UCONNFSAE/DashboardPCB/FSAE Main Panel/FSAE Main Panel.pdf

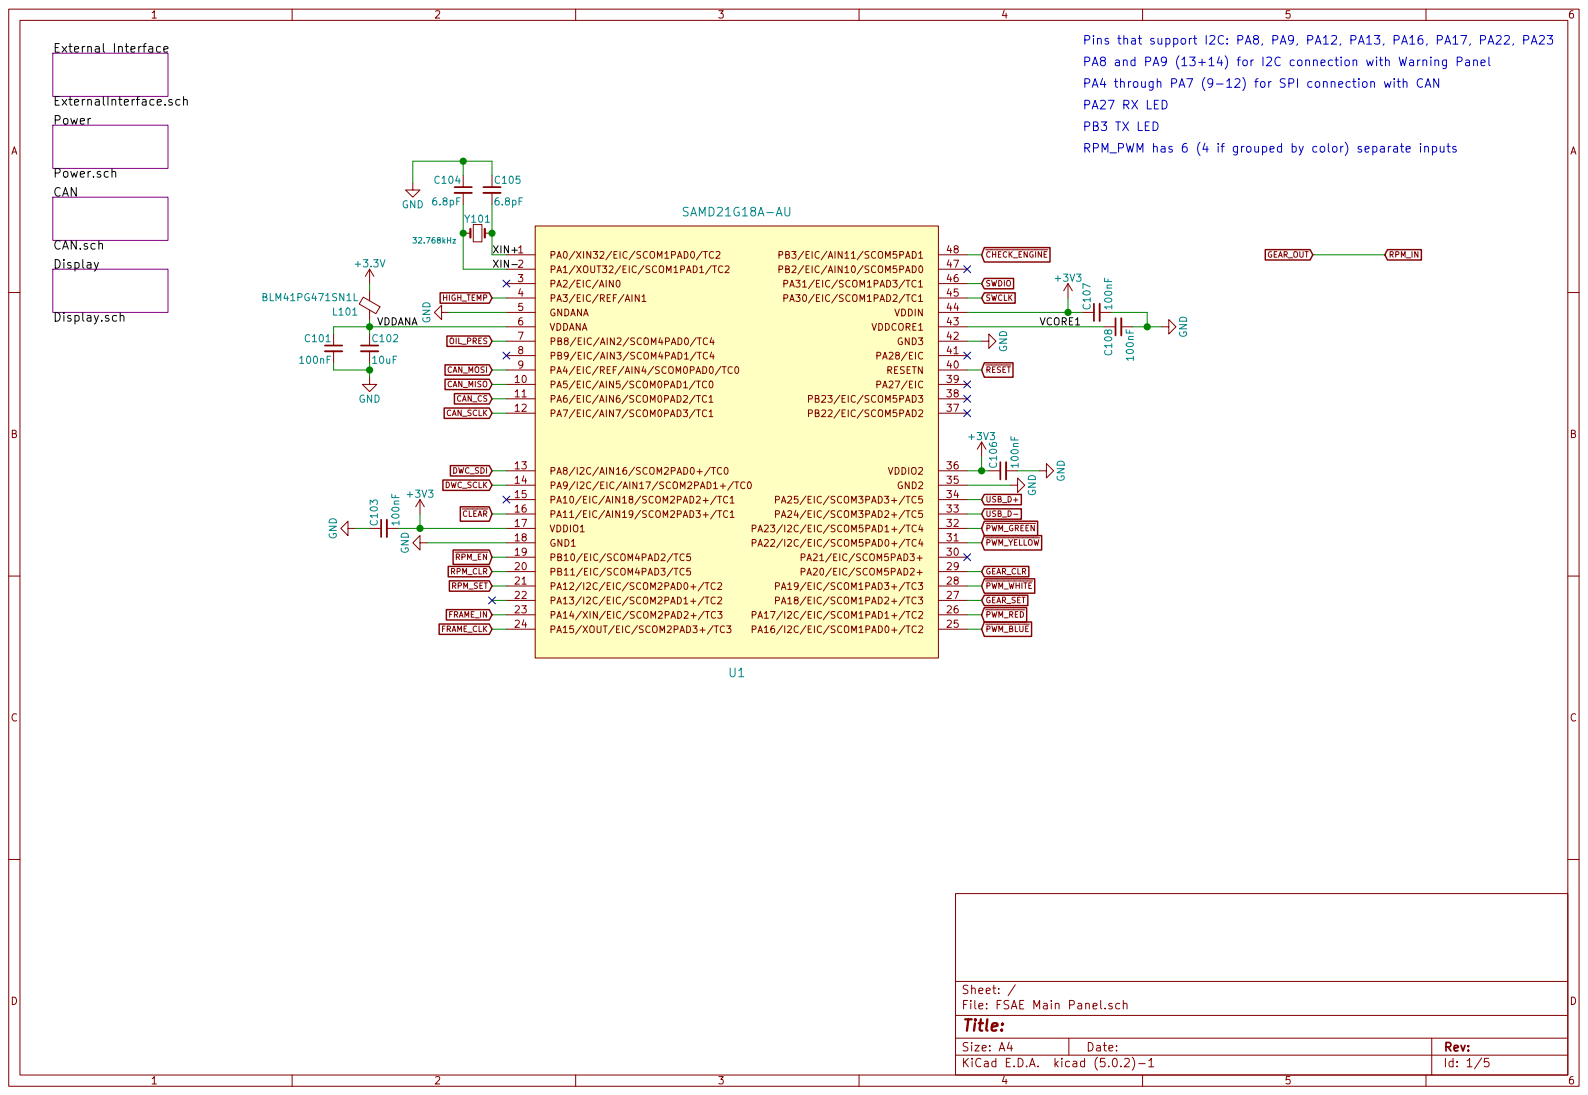
[picture p1: page 1]

External Interface ExternalInterface.sch Power Power.sch CAN

PA4 through PA7 (9-12) for SPI connection with CAN

PB3 TX LED
RPM_PWM has 6 (4 if grouped by color) separate inputs

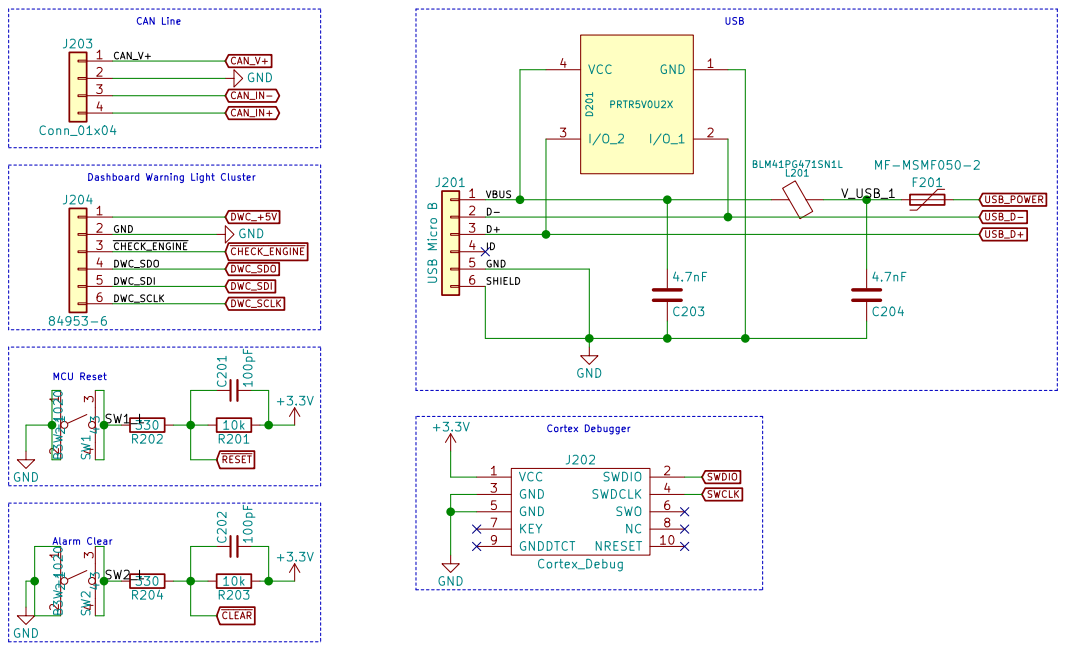
[picture p2: page 2]

DWC_SDI DWC_SCLK Dashboard Warning Light Cluster 1

4SW1 B3W-1020 MCU Reset Alarm Clear GND GND

Id: 2/5 Title: File: ExternalInterface.sch Sheet: /External Interface/

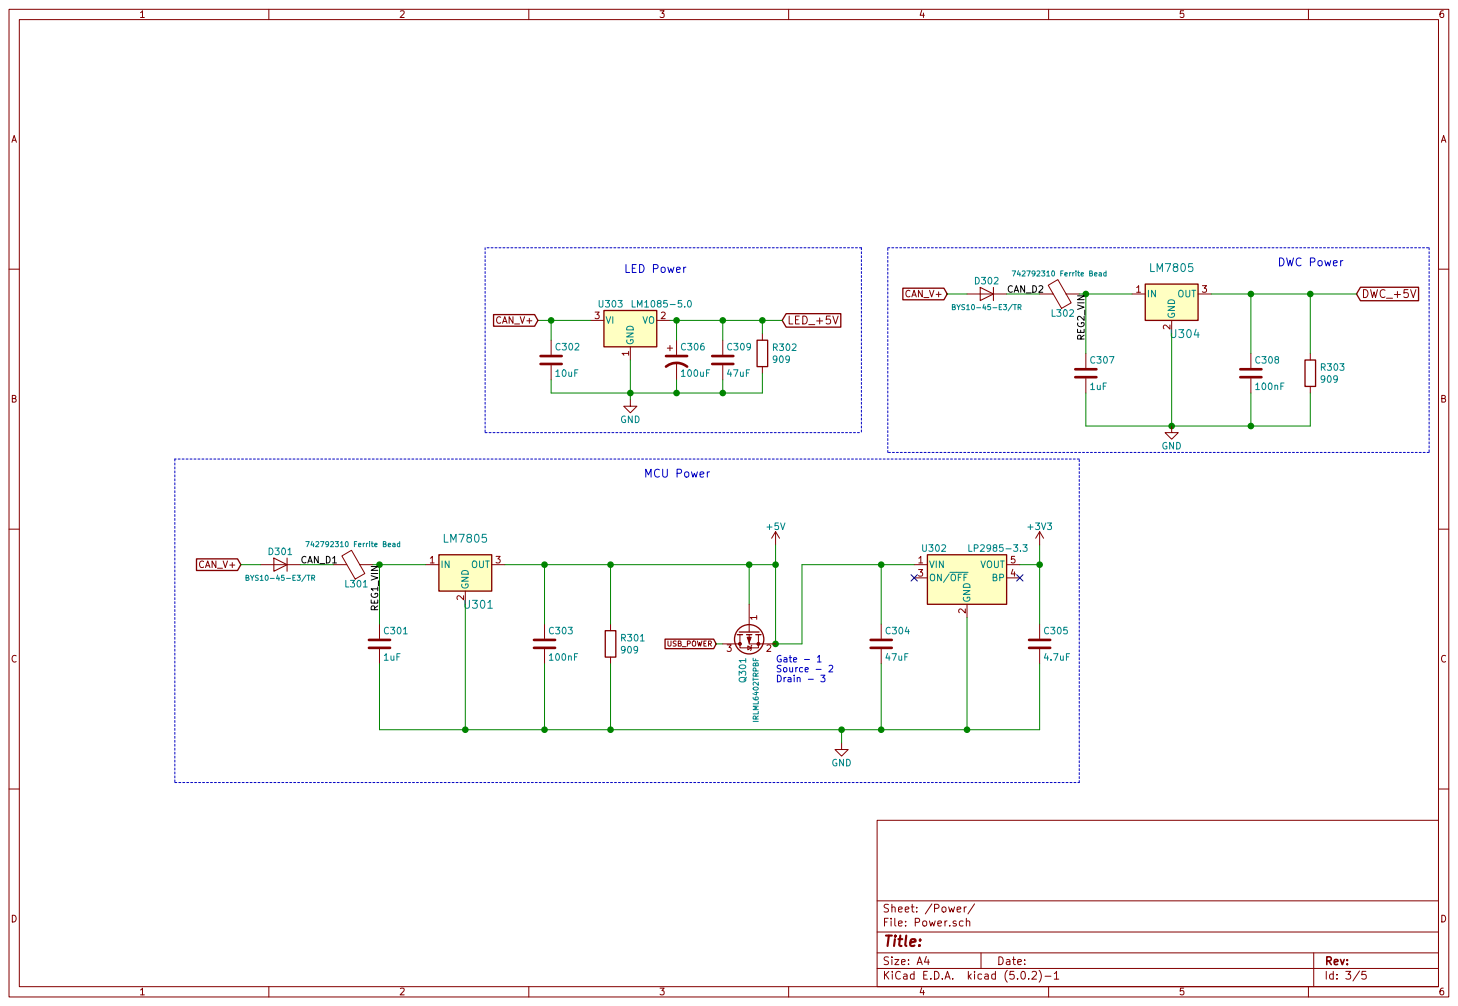
[picture p3: page 3]

Id: 3/5 Title: File: Power.sch Sheet: /Power/ D301

2 ON/OFF 3 BP 4 VOUT 5 U302 LP2985-3.3 C304

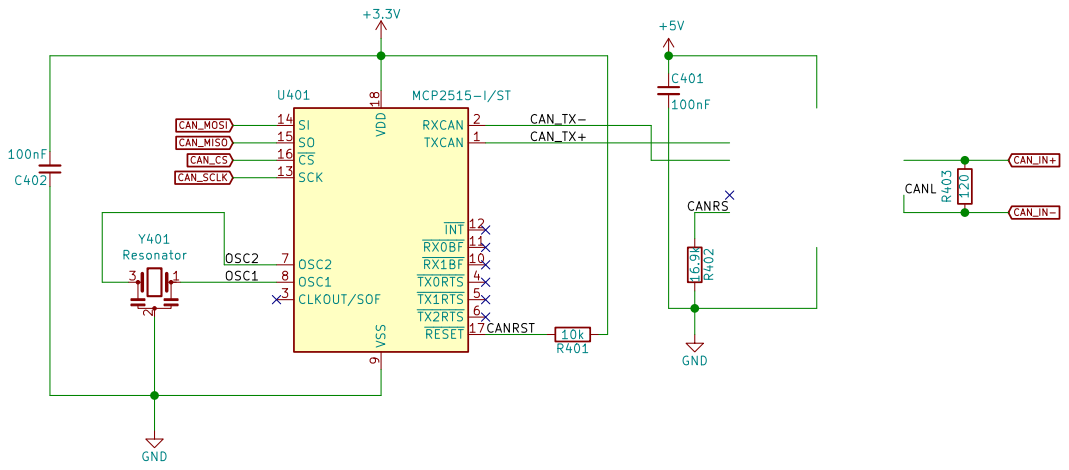
[picture p4: page 4]

Id: 4/5 Title: File: CAN.sch Sheet: /CAN/

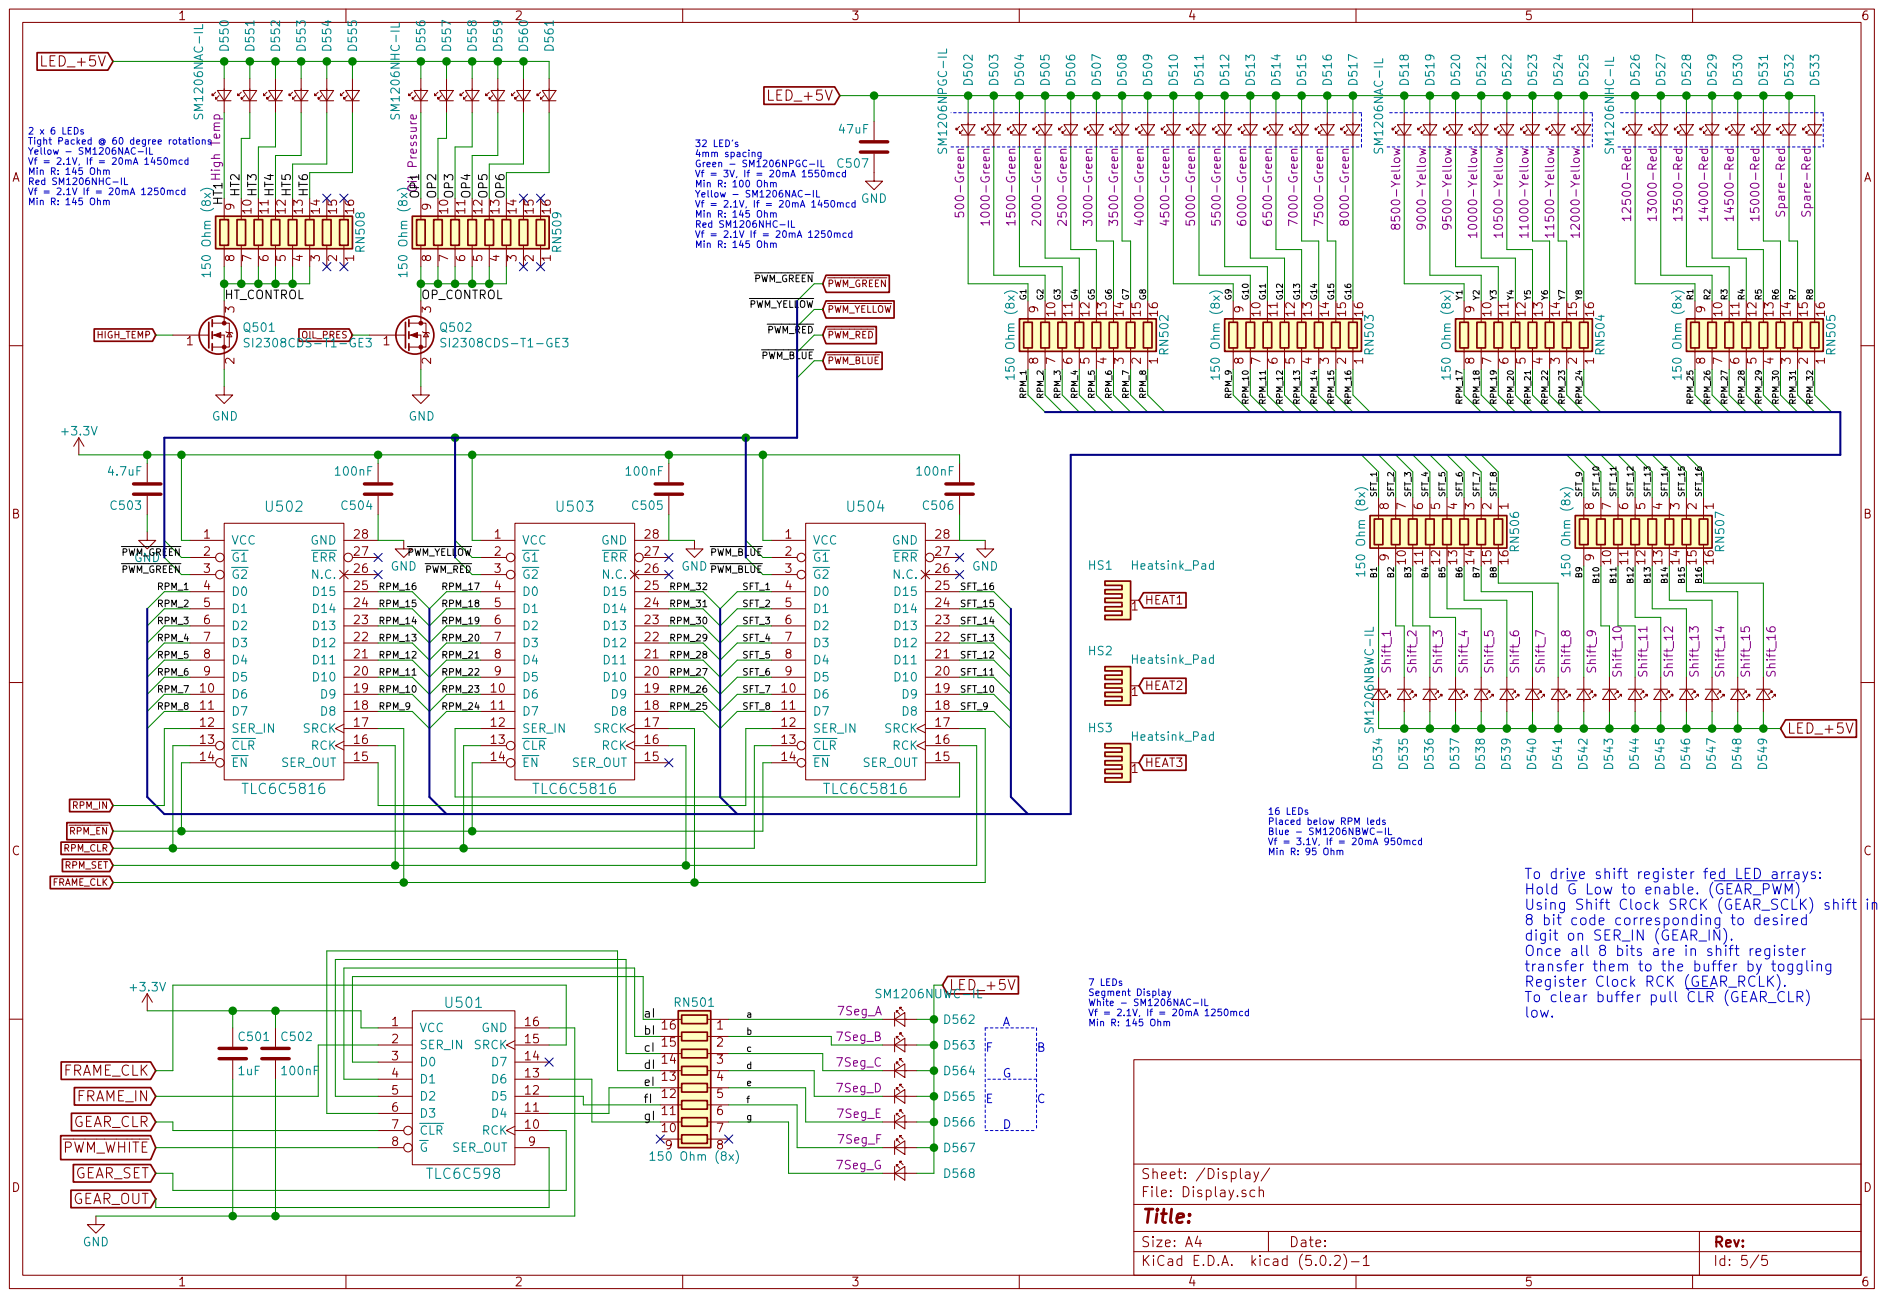
[picture p5: page 5]

9 RN509 150 Ohm (8x) D556 SM1206NHC-IL Oil Pressure D557 D558 D559 D560 D561 HIGH_TEMP OIL_PRES GND GND

2 x 6 LEDs Tight Packed @ 60 degree rotations Yellow - SM1206NAC-IL Vf = 2.1V, If = 20mA 1450mcd Min R: 145 Ohm

32 LED's 4mm spacing Green - SM1206NPGC-IL Vf = 3V, If = 20mA 1550mcd Min R: 100 Ohm

Red SM1206NHC-IL Vf = 2.1V If = 20mA 1250mcd Min R: 145 Ohm

Yellow - SM1206NAC-IL Vf = 2.1V, If = 20mA 1450mcd Min R: 145 Ohm

16 LEDs Placed below RPM leds Blue - SM1206NBWC-IL Vf = 3.1V, If = 20mA 950mcd Min R: 95 Ohm

Hold G Low to enable. (GEAR_PWM)
Using Shift Clock SRCK (GEAR_SCLK) shift in
8 bit code corresponding to desired
digit on SER_IN (GEAR_IN).
Once all 8 bits are in shift register
transfer them to the buffer by toggling
Register Clock RCK (GEAR_RCLK).
To clear buffer pull CLR (GEAR_CLR)

7 LEDs Segment Display White - SM1206NAC-IL Vf = 2.1V, If = 20mA 1250mcd Min R: 145 Ohm
