UCONNFSAE/DashboardPCB/Simulations/NMOS Simulation.asc

D1: diode
M1: nmos
R1: res; 220
V1: voltage; 5
V2: voltage; 3.3
Named nets: 0
.tran 1
