UCONNFSAE/DashboardPCB/FSAE Main Panel/FSAE Main Panel.kicad_pcb

## KiCad design FSAE Main Panel/FSAE Main Panel.kicad_pcb (2019-04-06)

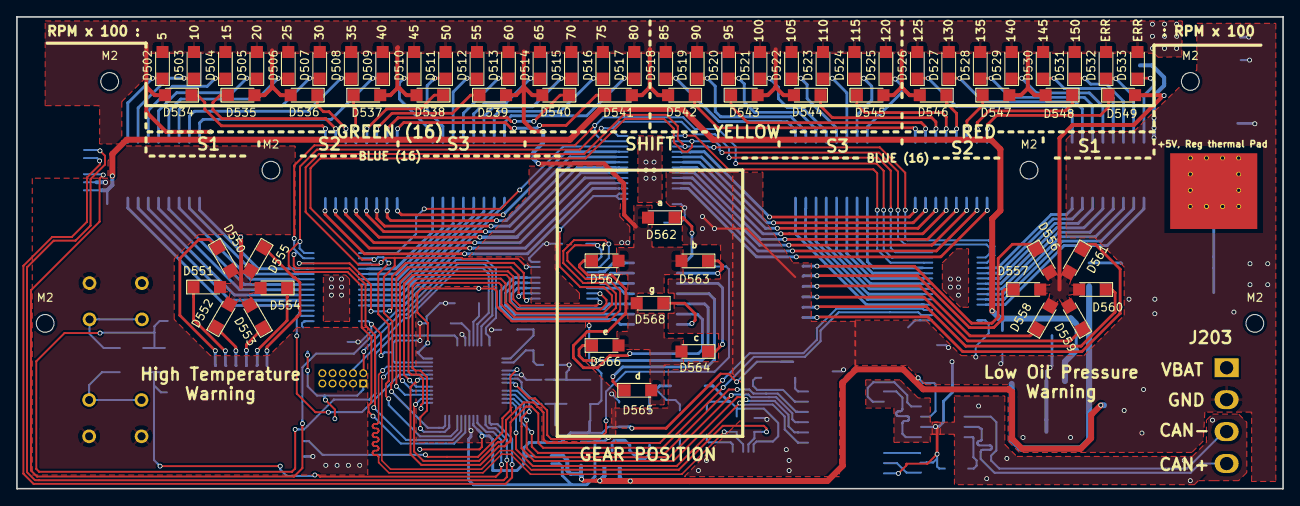
[picture p6: board FSAE Main Panel.kicad_pcb from above]

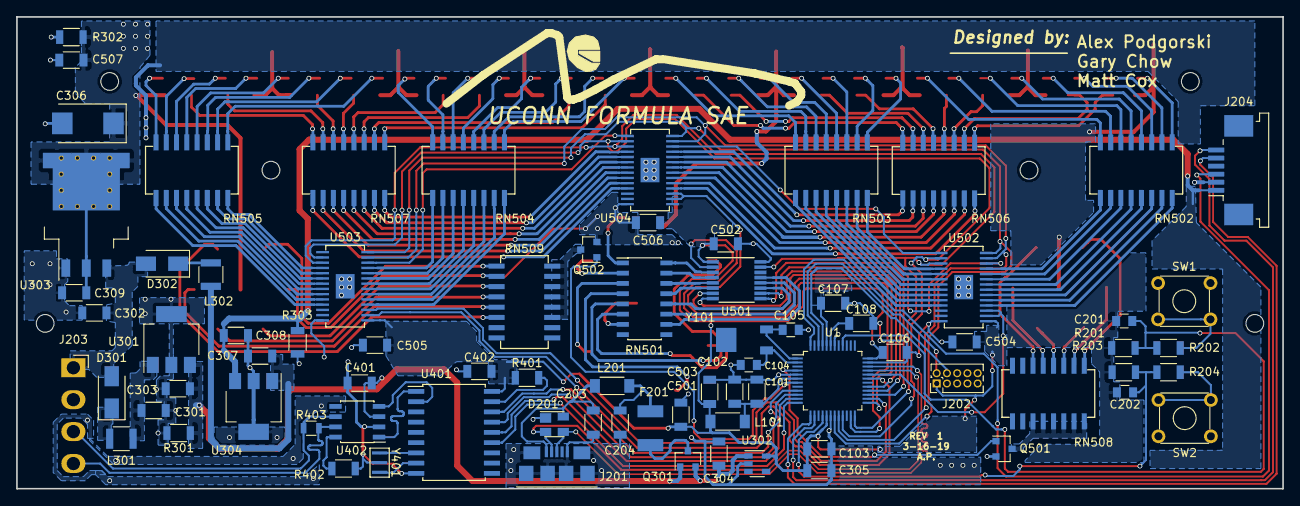
[picture p7: board FSAE Main Panel.kicad_pcb from below]

Board: 2 copper layers, 157.0 x 58.5 mm, 152 parts (79 on the bottom side), 181 nets.

Parts:
C101, C103, C106, C107, C108, C303, C308, C401, C402, C502, C504, C505, C506: 100nF; C_1206
C102, C302: 10uF; C_1206
C104, C105: 6.8pF; C_0805
C201, C202: 100pF; C_0805
C203, C204: 4.7nF; C_1206
C301, C307, C501: 1uF; C_1206
C304, C309, C507: 47uF; C_1206
C305, C503: 4.7uF; C_1206
C306: 100uF; CP_Tantalum_Case-D_EIA-7343-31_Reflow
D201: PRTR5V0U2X; SOT-143
D301, D302: BYS10-45-E3/TR; D_SMA
D502, D503, D504, D505, D506, D507, D508, D509, D510, D511, D512, D513, D514, D515, D516, D517, D562, D563, D564, D565, D566, D567, D568: LG R971; LED_1206
D518, D519, D520, D521, D522, D523, D524, D525, D550, D551, D552, D553, D554, D555: LY R976; LED_1206
D526, D527, D528, D529, D530, D531, D532, D533, D556, D557, D558, D559, D560, D561: LS R976; LED_1206
D534, D535, D536, D537, D538, D539, D540, D541, D542, D543, D544, D545, D546, D547, D548, D549: LB M673; LED_1206
F201: MF-MSMF050-2
J201: USB Micro B; 10118192-0001LF
J202: Cortex_Debug; Pin_Header_Straight_2x05_Pitch1.27mm
J203: Conn_01x04; JST_VH_B4PS-VH_2x4x3.96mm_Horizontal
J204: TE_84953-6_FPC; TE_84953-6_1x06_P1.0mm_Horizontal
L101, L201: BLM41PG471SN1L; L_1806
L301, L302: 742792310 Ferrite Bead; L_1210
M2, M2#2, M2#3, M2#4, M2#5, M2#6: MountingHole_2.2mm_M2
Q301: IRLML6402TRPBF; SOT-23
Q501, Q502: SI2308CDS-T1-GE3; SOT-23
R201, R203: 10K; R_1206
R202, R204: 330; R_1206
R301, R302, R303: 909; R_1206
R401: 10k; R_1206
R402: 16.9k; R_1206
R403: 120; R_0805
RN501: 51 Ohm (8x); SOIC-16_3.9x9.9mm_Pitch1.27mm
RN502, RN503: 151 Ohm (8x); Bourns 4800P SOM-16
RN504, RN508: 220 Ohm (8x); Bourns 4800P SOM-16
RN505, RN509: 180 Ohm (8x); Bourns 4800P SOM-16
RN506, RN507: 68 Ohm (8x); Bourns 4800P SOM-16
SW1, SW2: B3W-1020; SW_TH_Tactile_Omron_B3F-10xx
U1: SAMD21G18A-AU; TQFP-48_7x7mm_Pitch0.5mm
U301, U304: LM7805; SOT-223-3_TabPin2
U302: LP2985-3.3; SOT-23-5
U303: LM1085-5.0; TO-263-3_TabPin2_Tab
U401: MCP2515-I/ST; SOIC-18W_7.5x11.6mm_Pitch1.27mm
U402: MCP2551-I/SN; SOIC-8_3.9x4.9mm_Pitch1.27mm
U501: TLC6C598; TSSOP-16_4.4x5mm_Pitch0.65mm
U502, U503, U504: TLC6C5816
Y101: 32.768kHz; MS1V-T1K
Y401: Resonator; CSTNE16M0V530000R0

Connections:
+3V3: C103.2, C106.1, C107.1, C201.2, C202.2, C305.1, C402.2, C501.1, C502.1, C503.2, C504.2, C505.2, C506.2, J202.1, L101.2, R201.1, R203.1, R401.1, U1.17, U1.36, U1.44, U302.5, U401.18, U501.1, U502.1, U503.1, U504.1
+5V: C303.1, C304.1, C401.1, Q301.1, Q301.2, R301.1, U301.3, U302.1, U402.3
/CAN/CANRS: R402.1, U402.8
/CAN/CANRST: R401.2, U401.17
/CAN/CAN_TX+: U401.1, U402.1
/CAN/CAN_TX-: U401.2, U402.4
/CAN/OSC1: U401.8, Y401.1
/CAN/OSC2: U401.7, Y401.3
/Display/B1: D534.1, RN506.9
/Display/B2: D535.1, RN506.10
/Display/B3: D536.1, RN506.11
/Display/B4: D537.1, RN506.12
/Display/B5: D538.1, RN506.13
/Display/B6: D539.1, RN506.14
/Display/B7: D540.1, RN506.15
/Display/B8: D541.1, RN506.16
/Display/B9: D542.1, RN507.9
/Display/B10: D543.1, RN507.10
/Display/B11: D544.1, RN507.11
/Display/B12: D545.1, RN507.12
/Display/B13: D546.1, RN507.13
/Display/B14: D547.1, RN507.14
/Display/B15: D548.1, RN507.15
/Display/B16: D549.1, RN507.16
/Display/G1: D502.1, RN502.9
/Display/G2: D503.1, RN502.10
/Display/G3: D504.1, RN502.11
/Display/G4: D505.1, RN502.12
/Display/G5: D506.1, RN502.13
/Display/G6: D507.1, RN502.14
/Display/G7: D508.1, RN502.15
/Display/G8: D509.1, RN502.16
/Display/G9: D510.1, RN503.9
/Display/G10: D511.1, RN503.10
/Display/G11: D512.1, RN503.11
/Display/G12: D513.1, RN503.12
/Display/G13: D514.1, RN503.13
/Display/G14: D515.1, RN503.14
/Display/G15: D516.1, RN503.15
/Display/G16: D517.1, RN503.16
/Display/HT1: D550.1, RN508.9
/Display/HT2: D551.1, RN508.10
/Display/HT3: D552.1, RN508.11
/Display/HT4: D553.1, RN508.12
/Display/HT5: D554.1, RN508.13
/Display/HT6: D555.1, RN508.14
/Display/HT_CONTROL: Q501.3, RN508.3, RN508.4, RN508.5, RN508.6, RN508.7, RN508.8
/Display/OP1: D556.1, RN509.9
/Display/OP2: D557.1, RN509.10
/Display/OP3: D558.1, RN509.11
/Display/OP4: D559.1, RN509.12
/Display/OP5: D560.1, RN509.13
/Display/OP6: D561.1, RN509.14
/Display/OP_CONTROL: Q502.3, RN509.3, RN509.4, RN509.5, RN509.6, RN509.7, RN509.8
/Display/R1: D526.1, RN505.9
/Display/R2: D527.1, RN505.10
/Display/R3: D528.1, RN505.11
/Display/R4: D529.1, RN505.12
/Display/R5: D530.1, RN505.13
/Display/R6: D531.1, RN505.14
/Display/R7: D532.1, RN505.15
/Display/R8: D533.1, RN505.16
/Display/RPM_1: RN502.8, U502.4
/Display/RPM_2: RN502.7, U502.5
/Display/RPM_3: RN502.6, U502.6
/Display/RPM_4: RN502.5, U502.7
/Display/RPM_5: RN502.4, U502.8
/Display/RPM_6: RN502.3, U502.9
/Display/RPM_7: RN502.2, U502.10
/Display/RPM_8: RN502.1, U502.11
/Display/RPM_9: RN503.8, U502.18
/Display/RPM_10: RN503.7, U502.19
/Display/RPM_11: RN503.6, U502.20
/Display/RPM_12: RN503.5, U502.21
/Display/RPM_13: RN503.4, U502.22
/Display/RPM_14: RN503.3, U502.23
/Display/RPM_15: RN503.2, U502.24
/Display/RPM_16: RN503.1, U502.25
/Display/RPM_17: RN504.8, U503.4
/Display/RPM_18: RN504.7, U503.5
/Display/RPM_19: RN504.6, U503.6
/Display/RPM_20: RN504.5, U503.7
/Display/RPM_21: RN504.4, U503.8
/Display/RPM_22: RN504.3, U503.9
/Display/RPM_23: RN504.2, U503.10
/Display/RPM_24: RN504.1, U503.11
/Display/RPM_25: RN505.8, U503.18
/Display/RPM_26: RN505.7, U503.19
/Display/RPM_27: RN505.6, U503.20
/Display/RPM_28: RN505.5, U503.21
/Display/RPM_29: RN505.4, U503.22
/Display/RPM_30: RN505.3, U503.23
/Display/RPM_31: RN505.2, U503.24
/Display/RPM_32: RN505.1, U503.25
/Display/SFT_1: RN506.8, U504.4
/Display/SFT_2: RN506.7, U504.5
/Display/SFT_3: RN506.6, U504.6
/Display/SFT_4: RN506.5, U504.7
/Display/SFT_5: RN506.4, U504.8
/Display/SFT_6: RN506.3, U504.9
/Display/SFT_7: RN506.2, U504.10
/Display/SFT_8: RN506.1, U504.11
/Display/SFT_9: RN507.8, U504.18
/Display/SFT_10: RN507.7, U504.19
/Display/SFT_11: RN507.6, U504.20
/Display/SFT_12: RN507.5, U504.21
/Display/SFT_13: RN507.4, U504.22
/Display/SFT_14: RN507.3, U504.23
/Display/SFT_15: RN507.2, U504.24
/Display/SFT_16: RN507.1, U504.25
/Display/Y1: D518.1, RN504.9
/Display/Y2: D519.1, RN504.10
/Display/Y3: D520.1, RN504.11
/Display/Y4: D521.1, RN504.12
/Display/Y5: D522.1, RN504.13
/Display/Y6: D523.1, RN504.14
/Display/Y7: D524.1, RN504.15
/Display/Y8: D525.1, RN504.16
/Display/a: D562.1, RN501.1
/Display/aI: RN501.16, U501.3
/Display/b: D563.1, RN501.2
/Display/bI: RN501.15, U501.4
/Display/c: D564.1, RN501.3
/Display/cI: RN501.14, U501.5
/Display/d: D565.1, RN501.4
/Display/dI: RN501.13, U501.6
/Display/e: D566.1, RN501.5
/Display/eI: RN501.12, U501.11
/Display/f: D567.1, RN501.6
/Display/fI: RN501.11, U501.12
/Display/g: D568.1, RN501.7
/Display/gI: RN501.10, U501.13
/External Interface/SW1_L: R202.2, SW1.3, SW1.4
/External Interface/SW2_L: R204.2, SW2.3, SW2.4
/External Interface/VBUS: C203.2, D201.4, J201.1, L201.2
/External Interface/V_USB_1: C204.2, F201.2, L201.1
/Power/CAN_D1: D301.1, L301.2
/Power/CAN_D2: D302.1, L302.2
/Power/REG1_VIN: C301.1, L301.1, U301.1
/Power/REG2_VIN: C307.1, L302.1, U304.1
/VCORE1: C108.1, U1.43
/VDDANA: C101.1, C102.1, L101.1, U1.6
/XIN+: C105.2, U1.1, Y101.1
/XIN-: C104.2, U1.2, Y101.2
CAN_CS: U1.11, U401.16
CAN_IN+: J203.4, R403.2, U402.7
CAN_IN-: J203.3, R403.1, U402.6
CAN_MISO: U1.10, U401.15
CAN_MOSI: U1.9, U401.14
CAN_SCLK: U1.12, U401.13
CAN_V+: C302.1, D301.2, D302.2, J203.1, U303.3
DWC_+5V: C308.1, J204.1, R303.1, U304.3
DWC_SCLK: J204.6, U1.14
DWC_SDI: J204.5, U1.13
FRAME_CLK: U1.24, U501.15, U502.17, U503.17, U504.17
FRAME_IN: U1.23, U501.2
GEAR_CLR: U1.29, U501.7
GEAR_OUT: U501.9, U502.12
GEAR_SET: U1.27, U501.10
GND: C101.2, C102.2, C103.1, C104.1, C105.1, C106.2, C107.2, C108.2, C203.1, C204.1, C301.2, C302.2, C303.2, C304.2, C305.2, C306.2, C307.2, C308.2, C309.2, C401.2, C402.1, C501.2, C502.2, C503.1, C504.1, C505.1, C506.1, C507.1, D201.1, J201.5, J201.6, J202.3, J202.5, J203.2, J204.2, Q501.2, Q502.2, R301.2, R302.2, R303.2, R402.2, SW1.1, SW1.2, SW2.1, SW2.2, U1.5, U1.18, U1.35, U1.42, U301.2, U302.2, U303.1, U304.2, U401.9, U402.2, U501.16, U502.28, U503.28, U504.28, Y401.2
HIGH_TEMP: Q501.1, U1.4
LED_+5V: C306.1, C309.1, C507.2, D502.2, D503.2, D504.2, D505.2, D506.2, D507.2, D508.2, D509.2, D510.2, D511.2, D512.2, D513.2, D514.2, D515.2, D516.2, D517.2, D518.2, D519.2, D520.2, D521.2, D522.2, D523.2, D524.2, D525.2, D526.2, D527.2, D528.2, D529.2, D530.2, D531.2, D532.2, D533.2, D534.2, D535.2, D536.2, D537.2, D538.2, D539.2, D540.2, D541.2, D542.2, D543.2, D544.2, D545.2, D546.2, D547.2, D548.2, D549.2, D550.2, D551.2, D552.2, D553.2, D554.2, D555.2, D556.2, D557.2, D558.2, D559.2, D560.2, D561.2, D562.2, D563.2, D564.2, D565.2, D566.2, D567.2, D568.2, R302.1, U303.2
unnamed: U502.15, U504.12
unnamed: U503.12, U504.15
OIL_PRES: Q502.1, U1.7
RPM_CLR: U1.20, U502.13, U503.13, U504.13
RPM_SET: U1.21, U502.16, U503.16, U504.16
SWCLK: J202.4, U1.45
SWDIO: J202.2, U1.46
USB_D+: D201.3, J201.3, U1.34
USB_D-: D201.2, J201.2, U1.33
USB_POWER: F201.1, Q301.3
~CHECK_ENGINE: J204.3, U1.48
~CLEAR: C202.1, R203.2, R204.1, U1.16
~PWM_BLUE: U1.25, U504.2, U504.3
~PWM_GREEN: U1.32, U502.2, U502.3
~PWM_RED: U1.26, U503.3
~PWM_WHITE: U1.28, U501.8
~PWM_YELLOW: U1.31, U503.2
~RESET: C201.1, R201.2, R202.1, U1.40
~RPM_EN: U1.19, U502.14, U503.14, U504.14
