UCONNFSAE/DashboardPCB/(commit log)

2018-10-23 Added TE Connetor
    [FSAE Main Panel.sch]
2018-10-23 Test Pin Change
    [FSAE Main Panel.sch]
2018-10-23 Wires to TE connector
    [FSAE Main Panel.sch]
2018-10-24 Libraries used for PCB
2018-10-24 Power circuit to MCU
    [FSAE Main Panel.sch]
2018-10-24 Sheet Hierarchy
    [ExternalInterface.sch, FSAE Main Panel.sch]
2018-10-31 Hierarchy sheet for Power (WIP)
    [FSAE Main Panel.sch, Power.sch]
2018-11-07 Added CAN components
    [CAN.sch, ExternalInterface.sch, FSAE Main Panel.sch]
2018-11-10 Added Gear Shift LED display
    Included Gear shift LED 7 segment, resistor array, and shift register driver.
    Gary you'll need to re-add the custom library's youre using because they didn't get pushed to GitHub so KiCad ignored them when the project loaded without them. Components are still there, just until the libary's are re-added kicad doesn't know what to do with them.
    [CAN.sch, Display.sch, ExternalInterface.sch, FSAE Main Panel.kicad_pcb, FSAE Main Panel.sch, Power.sch]
2018-11-10 Attempt to fix custom library pathing
    [CAN.sch, Display.sch, ExternalInterface.sch, FSAE Main Panel.sch, Power.sch]
2018-11-12 Initial PCB layout
    Started PCB layout with major dimensions.
    Added RPM LEDs.
    Rearranged the file structure for the librarys and the search paths.
    [CAN.sch, Display.sch, ExternalInterface.sch, FSAE Main Panel.kicad_pcb, FSAE Main Panel.sch, Power.sch]
2018-11-12 Added RPM LED Control
    [CAN.sch, Display.sch, ExternalInterface.sch, FSAE Main Panel.kicad_pcb, FSAE Main Panel.sch, Power.sch]
2018-11-14 Added Blue shift LEDs and proper resistor arrays
    [Display.sch]
2018-11-16 Finished most LEDs, begun power regulators
    [Display.sch, ExternalInterface.sch, FSAE Main Panel.sch, Power.sch]
2018-11-19 Moved USB connection to External_Interface
    [ExternalInterface.sch, FSAE Main Panel.sch, Power.sch]
2018-11-25 Updated power circuit for MCU, used small components on main sheet
    [CAN.sch, Display.sch, ExternalInterface.sch, FSAE Main Panel.sch, Power.sch]
2018-11-28 Cortex debugger, GPIO pinning, minor fixes
    [CAN.sch, Display.sch, ExternalInterface.sch, FSAE Main Panel.sch, Power.sch]
2018-12-03 Added power regulator for LEDs, further GPIO considerations
    [Display.sch, ExternalInterface.sch, FSAE Main Panel.sch, Power.sch]
2018-12-27 Updated to KiCad 5
    [CAN.sch, Display.sch, ExternalInterface.sch, FSAE Main Panel.sch, Power.sch]
2019-01-06 Updated Footprint Association
    [CAN.sch, Display.sch, ExternalInterface.sch, FSAE Main Panel.sch, Power.sch]
2019-01-09 New footprints, finished associating footprints
    [CAN.sch, Display.sch, ExternalInterface.sch, FSAE Main Panel.sch, Power.sch]
2019-01-12 Edited footprints, started PCB layout
    [CAN.sch, Display.sch, FSAE Main Panel.kicad_pcb, Power.sch]
2019-01-19 Placed LEDs on PCB
    [FSAE Main Panel.kicad_pcb]
2019-01-21 Added Warning Lights
    Added Warning lights and started bulk routing
    [Display.sch, FSAE Main Panel.kicad_pcb]
2019-01-27 Updated PCB
    [CAN.sch, FSAE Main Panel.kicad_pcb, FSAE Main Panel.sch]
2019-02-20 Added warning nMOS circuit, simulated, updated PCB
    [Display.sch, FSAE Main Panel.kicad_pcb, FSAE Main Panel.sch, Power.sch]
2019-03-02 Major Revision
    Deleted a ton of routes, Sorry Gary.
    Changed all LEDs to 1206s for better brightness
    Added a lot of local net names for easier routing
    Flipped J203 for better routing
    Expanded board outline to fit final dashboard cutout
    Added half of the Mounting Holes
    Realigned RPM strip
    Added Linear Reg Load Resistors to meet minimum current specs
    Changed Aux load Linear Regulators to a better one
    Added Separate Linear Reg for the DWC
    Tuned the CAN Bus differential Pair Lines for equal length
    Added decoupling capacitors at a few locations
    Rerouted Power traces to be shorter and cleaner
    Set up keep out zones for CAN bus interference shielding.
    [CAN.sch, Display.sch, ExternalInterface.sch, FSAE Main Panel.kicad_pcb, FSAE Main Panel.sch, Power.sch]
2019-03-04 Power Supply Changes Again
    Shrunk some 5V layout by switching LM7805's for their SOT223 packages but with very careful top copper considerations for thermal management.
    Shrunk the Right side by 12mm for more clearance near ignition button.
    Fixed Shift Register clock signal routing.
    Changed shift order to be 7 segment first for easiler routing.
    Added Mounting Holes.
    TODO: Figure out Top layer 7 segment placement.
    [Display.sch, ExternalInterface.sch, FSAE Main Panel.kicad_pcb, FSAE Main Panel.sch, Power.sch]
2019-03-04 Minor Routing changes
    [FSAE Main Panel.kicad_pcb]
2019-03-09 More Routing
    Fixed Tactile Switch Footprints
    More routing
    [ExternalInterface.sch, FSAE Main Panel.kicad_pcb, FSAE Main Panel.sch]
2019-03-12 Plotted schematic PDF file
2019-03-13 Most Signal Routing
    Todo: Figure out 7 segment LED placements and route their power traces
    [Display.sch, FSAE Main Panel.kicad_pcb, FSAE Main Panel.sch]
2019-03-16 Version 1
    [Display.sch, FSAE Main Panel.kicad_pcb, FSAE Main Panel.sch, Power.sch]
2019-03-20 Initial Fabrication
    [CAN.sch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]
2019-03-28 Manufacturing Tweaks
    [Display.sch, FSAE Main Panel.kicad_pcb]
2019-03-31 Updated attributes and BOM
    Standardized the component attributes and BOM.
    Some errors were identified and will be corrected in the next board revision
    [CAN.sch, Display.sch, ExternalInterface.sch, FSAE Main Panel.kicad_pcb, FSAE Main Panel.sch, FSAE Main Panel_bom_.csv, Power.sch]
2019-04-03 TLC6C5816 test code on SAMD21
    Sends data and PWM signals to TLC6C5816 using SAMD21 in arduino
2019-04-03 TLC6C5816 test code on Arduino Uno
2019-04-06 Schematic PDF, minor fixes in PCB, test code
    [ExternalInterface.sch, FSAE Main Panel.kicad_pcb]
2019-04-06 Dashboard test code
    [CAN.sch, FSAE Main Panel.sch]
2019-04-06 Successfully tested CAN Bus SPI on the Dashboard PCB
2019-04-10 Fixed PWM output, figuring frame data
    [Dashboard_Test.ino]
2019-04-11 Dashboard LED through SPI
2019-04-17 Upload test code for CAN bus and clock output
2019-04-20 Warning Panel I2C testing
2019-04-22 Further testing of CAN BUS and I2C LED Driver
2019-04-22 Working CAN BUS code
2019-04-23 Added CAN BUS to SPI test
2019-04-24 Further LED testing and added gear position from CAN
2019-04-25 Working gear indicator
2019-04-26 Working Gear on display, properly reading rpm, eop and ect
2019-09-14 Added oil pressure vs RPM logic
2019-09-14 Custom Variant file required for dashboard code
    Found in *\AppData\Local\Arduino15\packages\SparkFun\hardware\samd\1.5.4\variants
